vquentin/sar1/Quentin_sar.pptx

## Design of a SAR for LEO

Quentin Van Overmeere

## Choice of frequency band

Center f (GHz) | Advantages | λ (cm) | Power requirements (mW) | λboard (cm)
2.4 (L band) | Cheapest components Penetrates objects | 12
5.0 (C band) | Cheap components | 6
10 (X band) | Highest resolution | 3

R_r =c/(2B) and B is higher at higher frequencies. B ~ 0.5 GHz for Rr of 0.3 m
R_a =L/2 (spotlight mode SAR), but there are constraints on smallest L:
- (2v)/L<τ → τ>28…4.6 kHz
- TBD to satisfy max ground station data transmit rate
- τ<c/2w → w<5…32 km
- TBD to satisfy antenna radiation requirements
Assuming θ of 0.3 rad, H of 300 km (R is 2000 km max), L of 0.5 to 3 m, v 7000 m/s

## First design

Objectives
- Build a 5 GHz FMCW radar
- Familiarize hands-on with hardware and software required
- Understand the trade-offs
- First step to SAR prototype

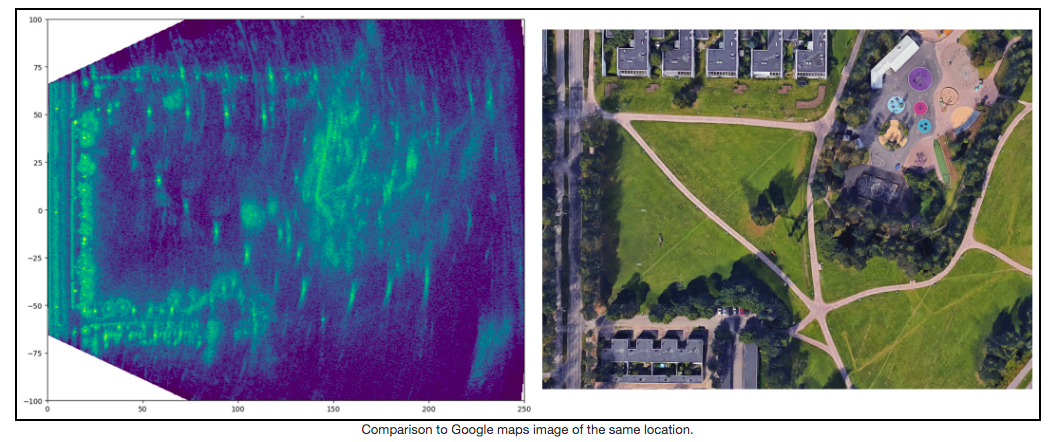
[picture p1: figure]

https://hforsten.com/6-ghz-frequency-modulated-radar.html

## Block diagram

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
## Component selection (in progress)

Use 5180-5825 MHz wifi band
- VCO: HMC431LP4E (https://www.mouser.be/ProductDetail/Analog-Devices/HMC431LP4E?qs=3izLlwrMQ7koKJkU3m2Tkw%3D%3D) 5.5-6.1 GHz, 18.33 €
- PA: TQP5525 (https://www.mouser.be/ProductDetail/Qorvo/TQP5525?qs=QQJxVsr8EGZtUXwNw3GLVg%3D%3D) 6.61 €
- Mixer: LTC5552IUDB#TRMPBF (https://www.mouser.be/ProductDetail/Analog-Devices/LTC5552IUDBTRMPBF?qs=BZBei1rCqCD%252BONDnYELoig%3D%3D), 31.76 €
- LNA: SKY65404-31, 1 €
- Various filters: cheap
- Voltage converters: cheap
- MCU: ARM Cortex M0 Dual LPC4320FET100,551 (https://www.mouser.be/ProductDetail/NXP-Semiconductors/LPC4320FET100551?qs=fhAOlxDPaYXMudIosCh2iw%3D%3D), 10 €

## Timeline & milestones

- 1 yr ± 6 mo to engineering prototype (vs. 2 yr order-of-magnitude from George)
- f < 10 GHz for design simplicity, unless weight constraints
- Testing
  - Drones 45-90 m
  - Aeroclub 3-4 km
  - …

## Additional ideas

- Boost S/N of Rx by leveraging coldness of space
- Leverage constellation by separating Tx/Rx

## Leveraging contacts

George Daniel, radar lead at Cruise
- ex-Xerox PARC
- Phased arrays, beam-forming, metamaterial antennas & SAR
- Could be a go-to person for troubleshooting and generating new ideas (beyond UCLouvain-network)
