vquentin/sar1/datasheets/HMC431 VCO/devboard.png

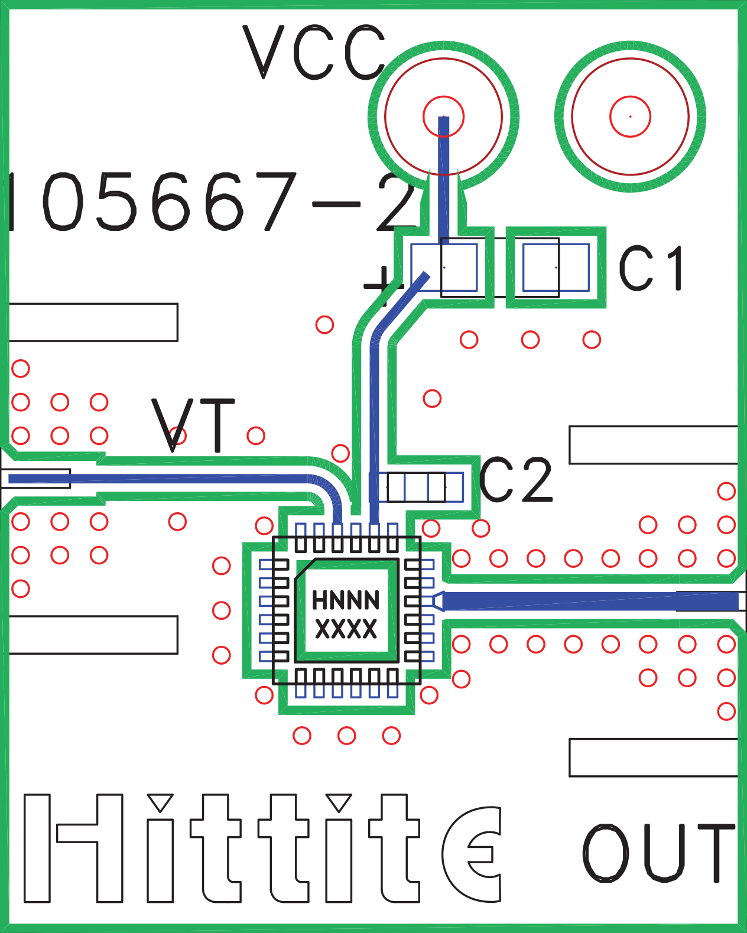
datasheets/HMC431 VCO/devboard.png
