vquentin/sar1/datasheets/HMC431 VCO/HMC431_Design Files/HMC431_BOM.xls

Omnify BOM Report105706 - LM, EVAL
Item | Part Number | Qty | Refdes | Description | Manufacturer | MFR Part Number
1 | 105667 | 0 |  | PCB, EVAL
2 | 105192 | 2 | J1,J2 | SCD, COMP, SMA CONNECTOR, JOHNSON | Johnson Components | 142-0701-851
3 | 105705 | 0 |  | AD, EVAL
4 | 105193 | 2 | VCC, GND | COMP, MILL-MAX DC PIN | Mill-Max | 3101-2-00-21-00-00-08-0
5 | 105065-002 | 1 | C1 | CAP TANT 4.7UF 16V 20% SMD 3216 | AVX Corporation | AJA475M016RNJ
6 | 105060-001 | 1 | C2 | CAP CER 10000PF 50V 10% X7R 0603 | AVX Corporation | 06035C103KAT2A
7 | 104840 | 0 |  | PC, PROCESS CARD, EVALUATION PCB ASSEMBLY
19 | 480-HMC431LP4-00 | 0 | U1 | MMIC VCO w/ BUFFER AMPLIFIER | ADI | HMC431LP4E
