vquentin/sar1/simulations/integrator_TS97x.asc

C1: cap; 10µ
R1: res; 10k
U1: TS97x
V1: voltage; 2
V2: voltage; +5
V3: voltage; 5
Named nets: 0, Vout
.tran 0 0.5 0 uic
.ic V(Vout) = 0
