vquentin/sar1/simulations/single_supply_integrator.asc

C1: cap; 10µ
C2: cap; 1m
R1: res; 100k
R2: res; 10k
R3: res; 10k
R4: res; 10k
U2: TS97x
V1: voltage; 10; Rser=0
V2: voltage; 3; Rser=0
Named nets: 0, Vout
.tran 0 0.5 0 uic
.ic V(Vout) = 0
