vquentin/sar1/schematics/Tx.kicad_pcb

## KiCad design schematics/Tx.kicad_pcb (2021-11-30)

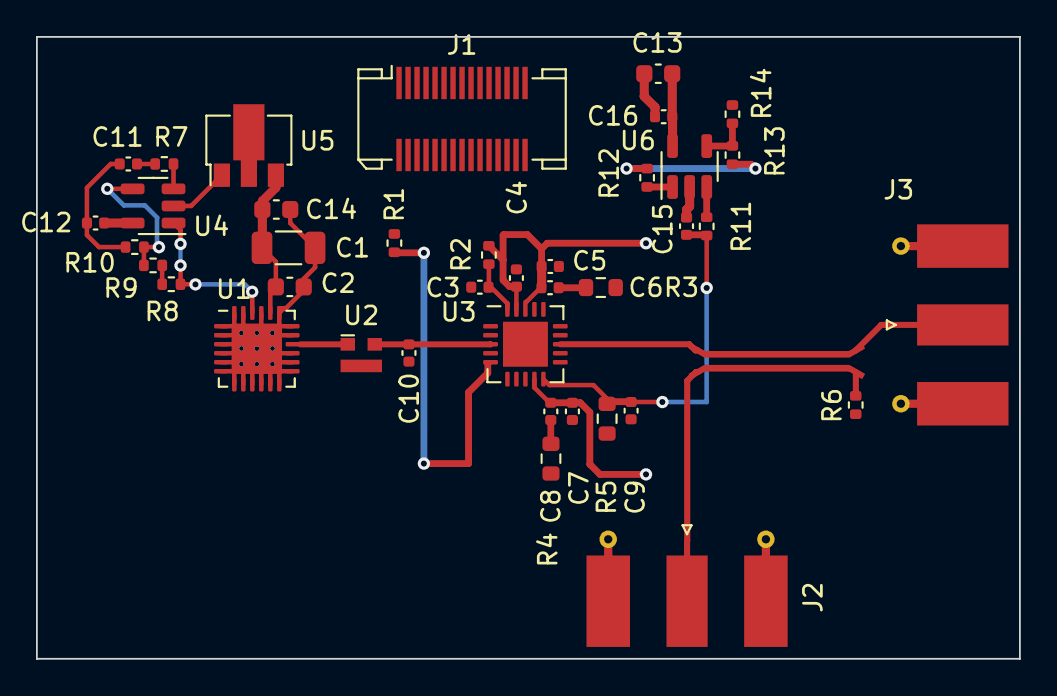
[picture p3: board Tx.kicad_pcb from above]

Board: 4 copper layers, 54.6 x 34.5 mm, 40 parts (0 on the bottom side), 25 nets.

Parts:
C1: 4.7 uF; C_1206_3216Metric
C2: 10,000 pF; C_0603_1608Metric
C3, C4: 0.1 uF; C_0402_1005Metric
C5, C7: 10 uF; C_0402_1005Metric
C6, C8, C9: 220 pF; C_0402_1005Metric
C10: 0.3 pF; C_0402_1005Metric
C11, C12, C15, C16: 100n; C_0402_1005Metric
C13, C14: 1 uF; C_0603_1608Metric
J1: Conn_02x15_Counter_Clockwise; Molex_SlimStack_52991-0308_2x15_P0.50mm_Vertical
J2, J3: PCB edge; SMA_Molex_73251-1153_EdgeMount_Horizontal
R1: 50k; R_0402_1005Metric
R2: 27; R_0402_1005Metric
R3, R4: 2; R_0603_1608Metric
R5: 27.4k; R_0603_1608Metric
R6: 49.9; R_0402_1005Metric
R7, R11: 100; R_0402_1005Metric
R8, R9, R10, R12, R13, R14: 10k; R_0402_1005Metric
RF1: Coupler; -24 dB coupler 5.5 GHz OSHpark 4 layers
U1: HMC431; QFN-24-1EP_4x4mm_P0.5mm_EP2.8x2.8mm
U2: PAT1220-C-10DB; RF_Attenuator_Susumu_PAT1220
U3: TQP5525; QFN-20-1EP_4x4mm_P0.5mm_EP2.5x2.5mm
U4, U6: TS971ILT; SOT-23-5
U5: MCP1700T-3002E/MB; SOT-89-3

Connections:
+3V3: C13.1, C16.1, J1.2, J1.4, J1.5, J1.6, J1.16, J1.17, U5.2 (VI), U6.5 (V+)
+5V: C4.1, C5.1, C6.1, C7.2, C8.1, J1.8, J1.9, J1.10, J1.12, R2.1, U3.9 (VCC3), U3.18 (VCC3), U3.19 (VCC2)
+10V: C12.1, J1.14, U4.5 (V+)
/3V0: C1.1, C2.1, C14.1, U1.20 (VCC), U5.3 (VO)
/DAC: C11.2, R7.1
/PA_DET: C9.1, C15.2, R5.1, R11.1, U3.10 (DET)
/PA_DET_G: J1.29, R12.1, U6.1
/PA_EN: J1.30, R1.1, U3.5 (PA_EN)
/RF_COUPLER_2: J3.1 (In), RF1.2
/RF_COUPLER_3: R6.1, RF1.3
/RF_COUPLER_4: J2.1 (In), RF1.4
/RF_I_PAMP: C10.1, U2.2, U3.3 (RF_IN)
/RF_O_PAMP: RF1.1, U3.13 (RF_OUT)
/RF_O_VCO: U1.16 (RFOUT), U2.1
/VTUNE: R8.1, U1.22 (VTUNE), U4.1
GND: C1.2, C2.2, C3.2, C4.2, C5.2, C7.1, C9.2, C10.2, C11.1, C12.2, C13.2, C14.2, C15.1, C16.2, J1.1, J1.3, J1.7, J1.11, J1.13, J1.15, J1.18, J1.21, J1.26, J2.2 (Ext), J3.2 (Ext), R1.2, R3.1, R4.1, R5.2, R6.2, R10.2, R14.2, U1.1 (NC), U1.2 (NC), U1.3 (NC), U1.4 (NC), U1.5 (NC), U1.6 (NC), U1.7 (NC), U1.8 (NC), U1.9 (NC), U1.10 (NC), U1.11 (NC), U1.12 (NC), U1.13 (NC), U1.14 (NC), U1.15 (GND), U1.17 (NC), U1.18 (NC), U1.19 (NC), U1.21 (NC), U1.23 (NC), U1.24 (NC), U1.25 (GND), U2.3, U3.1 (GND), U3.2 (GND), U3.4 (GND), U3.11 (GND), U3.12 (GND), U3.14 (GND), U3.15 (GND), U3.16 (GND), U3.17 (GND), U3.21 (GND), U4.2 (V-), U5.1 (GND), U6.2 (V-)
unnamed: C3.1, R2.2, U3.20 (VCC1)
unnamed: C6.2, R3.2
unnamed: C8.2, R4.2
unnamed: R7.2, U4.3 (+)
unnamed: R8.2, R9.1
unnamed: R9.2, R10.1, U4.4 (-)
unnamed: R11.2, U6.3 (+)
unnamed: R12.2, R13.1
unnamed: R13.2, R14.1, U6.4 (-)
