vquentin/sar1/(commit log)

2021-09-24 The first commit
    [Tx.kicad_pcb, Tx.sch]
2021-09-28 Before footprint assignments check
    [Tx.kicad_sch, analog.kicad_pcb, analog.kicad_sch, op_amp_gain.kicad_sch, sar.xlsx]
2021-11-30 Added Rx board
    [HMC431_BOM.xls, HMC431_eval.kicad_pcb, Rx.kicad_sch, Tx.csv, Tx.kicad_pcb, Tx.kicad_sch, components.kicad_pcb, op_amp_gain.kicad_sch]
2022-01-04 latest updates
    [Rx.kicad_sch, op_amp_gain.kicad_sch, prototype.csv, prototype.kicad_sch]
