vquentin/sar1/(notices)

Notices in the files:
parts and their libraries:
COPYRIGHT: Copyright C 2016 Accelerated Designs. All rights reserved
